kkatano/bakeneko-60/(notices)

Notices in the files:
pcb/matrix.sch:
Copyright © 2020 kkatano
MIT License
